zybzyb1/xuanghe_project/bat_voltage_monitoring/单片机PY32F002AW152K6.jpg

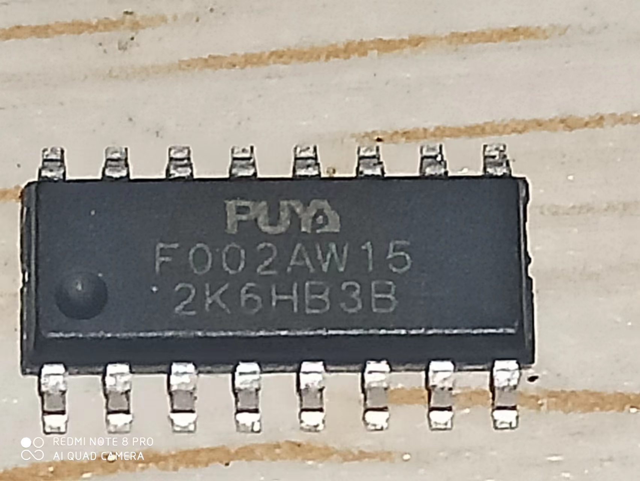
bat_voltage_monitoring/单片机PY32F002AW152K6.jpg
