zybzyb1/xuanghe_project/bat_voltage_monitoring/BOM_电压监测板元件清单.xlsx

No. | Quantity | Comment | Designator | Footprint | Value | Manufacturer Part | Manufacturer | Supplier Part | Supplier
1 | 5 | 100nF | C1,C2,C3,C10,C12 | 0603C | 100nF | C1206C104K1RAC7800 | KEMET(基美) | C141183 | LCSC
2 | 1 | 47uF | C13 | C1206 | 47uF | 0805X476M6R3NT | FH(风华) | C3019011 | LCSC
3 | 1 | 1N4007G | D1 | SMA_L4.4-W2.6-LS5.0-RD |  | 1N4007G | SHIKUES(时科) | C111122 | LCSC
4 | 1 | PZ254V-11-04P | H2 | HDR-TH_4P-P2.54-V-M |  | PZ254V-11-04P | XFCN(兴飞) | C2691448 | LCSC
5 | 1 | 5631AS | LED1 | LED-SEG-TH_12P-L37.6-W19.0-P2.54-S15.2-BL |  | 5631AS |  | C10008 | LCSC
6 | 1 | MHLC5019UEGTD | LED2 | LED-TH_3P-BD5.9-P2.54-BI |  | MHLC5019UEGTD | MEIHUA(美华) | C473816 | LCSC
7 | 3 | S9013 | Q1,Q2,Q3 | SOT-23-3_L2.9-W1.3-P1.90-LS2.4-BR |  | S9013 | ElecSuper(静芯微） | C5249679 | LCSC
8 | 2 | 1kΩ | R1,R21 | 0603R | 1kΩ | CRCW060312K0FKEAC | VISHAY(威世) | C844123 | LCSC
9 | 7 | 470Ω | R2,R12,R13,R14,R15,R17,R18 | 0603R | 470Ω | CRCW060312K0FKEAC | VISHAY(威世) | C844123 | LCSC
10 | 1 | 9.1KΩ 1% | R4 | 0603R | 9.1KΩ 1% | CRCW060312K0FKEAC | VISHAY(威世) | C844123 | LCSC
11 | 1 | 5.1KΩ 1% | R5 | 0603R | 5.1KΩ 1% | CRCW060312K0FKEAC | VISHAY(威世) | C844123 | LCSC
12 | 1 | 100Ω | R6 | 0603R | 100Ω | CRCW060312K0FKEAC | VISHAY(威世) | C844123 | LCSC
13 | 1 | 2Ω | R7 | R0805 | 2Ω | CRCW060312K0FKEAC | VISHAY(威世) | C844123 | LCSC
14 | 2 | 510Ω | R8,R9 | 0603R | 510Ω | CRCW060312K0FKEAC | VISHAY(威世) | C844123 | LCSC
15 | 1 | 1k | R19 | 0603R | 1k | CRCW060312K0FKEAC | VISHAY(威世) | C844123 | LCSC
16 | 1 | 10kΩ | R32 | 0603R | 10kΩ | CRCW060312K0FKEAC | VISHAY(威世) | C844123 | LCSC
17
18 | 1 | LR2010B-M50 | U2 | SOT-89-3_L4.5-W2.5-P1.50-LS4.2-BR |  | LR2010B-M50 | LR(朗瑞) | C459773 | LCSC
