zybzyb1/xuanghe_project/bat_voltage_monitoring/pcbsch/外壳CADzyb_recover.dxf

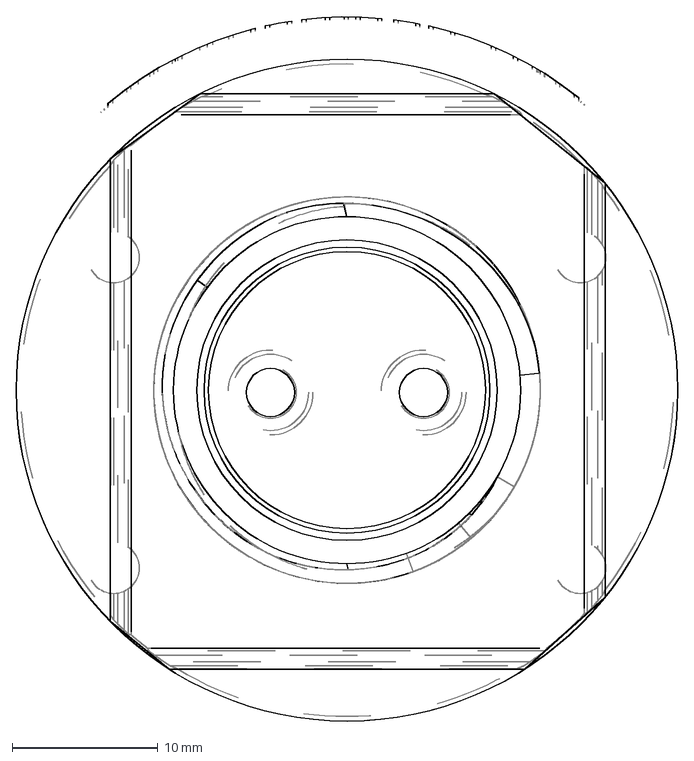
[picture p2: CAD file, 2023-04-02]
bat_voltage_monitoring/pcbsch/外壳CADzyb_recover.dxf
45.4 x 48.4 mm
