zybzyb1/xuanghe_project/(list of files, cad)

Other CAD files:
bat_voltage_monitoring/pcbsch/外壳CAD.dwg
bat_voltage_monitoring/pcbsch/外壳CADzyb.dwg
bat_voltage_monitoring/pcbsch/外壳CADzyb_recover.dwg
