zybzyb1/xuanghe_project/(list of files, drawings)

Other design files:
bat_voltage_monitoring/pcbsch/bat_voltage_monitoring第一版.eprj
