zybzyb1/xuanghe_project/bat_voltage_monitoring/code/PY32F002A-vol/PY32F0xx_Firmware_V1.1.2/Projects/PY32F002A-STK/Example/ADC/ADC_TempSensor/Inc/main.h

/**
  ******************************************************************************
  * @file    main.h
  * @author  MCU Application Team
  * @brief   Header for main.c file.
  *          This file contains the common defines of the application.
  *****************************************************************************/

/* Define to prevent recursive inclusion -------------------------------------*/

#ifndef __MAIN_H
#define __MAIN_H

#ifdef __cplusplus
extern "C" {
#endif

/* Includes ------------------------------------------------------------------*/
#include "py32f0xx_hal.h"
#include "py32f002xx_Start_Kit.h"

/* Private includes ----------------------------------------------------------*/
/* Exported functions prototypes ---------------------------------------------*/
void Error_Handler(void);

/* Exported functions prototypes ---------------------------------------------*/
/* Private defines -----------------------------------------------------------*/

#ifdef __cplusplus
}
#endif

#endif /* __MAIN_H */

/************************ (C) COPYRIGHT Puya *****END OF FILE****/
