zybzyb1/xuanghe_project/bat_voltage_monitoring/code/PY32F002A-vol/PY32F0xx_Firmware_V1.1.2/Projects/PY32F002A-STK/Example/ADC/ADC_TempSensor/Src/user/led.c

#include  "led.h"
#include  "user_gpio.h"
#include  "global.h"

u8 led_mode;

void led_init(void)
{
     led_mode = 0;


}
void led_run(void)
{

   switch(led_mode)
	{
		case 0:
		{
			 LED_RED_OFF();
			 LED_GREEN_OFF();
			 break;
		}
		case 1:
		{
			LED_RED_ON();
			LED_GREEN_OFF();
			break;
		}
		case 2:
		{
			LED_RED_OFF();
			LED_GREEN_ON();
			break;
		}
		case 3:
		{
			LED_RED_ON();
			LED_GREEN_ON();
			break;
		}
	  default:
		
		break;
	
	}
  
}
